bvksound/UPZ_Switcher/BOM/BOM UPZ Switcher.xlsx

Part | Type | Supplier | Amount | Unit price | Total (Unit Price) | Description
N/A |  | JLCPCB | 1 |  | 0 | PCB
NC3FDH (https://benl.rs-online.com/web/p/xlr-connectors/0448250/?searchHistory=%7B%22enabled%22%3Atrue%7D) | XLR | RSComponents | 8 | 4.92 | 39.36
NC3MDH (https://benl.rs-online.com/web/p/xlr-connectors/0448238/?searchHistory=%7B%22enabled%22%3Atrue%7D) | XLR | RSComponents | 2 | 4.77 | 9.54
861-4281 (https://benl.rs-online.com/web/p/leds/8614281/?searchHistory=%7B%22enabled%22%3Atrue%7D) | LED | RSComponents | 4 | 0.128 | 0.512 | LED Green Red
861-4278 (https://benl.rs-online.com/web/p/leds/8614278/?searchHistory=%7B%22enabled%22%3Atrue%7D) | LED | RSComponents | 1 | 0.144 | 0.144 | LED Yellow Red
446-5243 (https://benl.rs-online.com/web/p/d-sub-connectors/4465243/?searchHistory=%7B%22enabled%22%3Atrue%7D) | DB9 | RSComponents | 1 | 2.32 | 2.32 | DB9 connector
TQ2SA-5V (https://benl.rs-online.com/web/p/high-frequency-rf-relays/8154874/) | Relay | RSComponents | 18 | 3.17 | 57.06 | Relay
 | Mosfet |  | 18 |  |  | B170
 | Resistor |  | 4 |  |  | 6K8 Phantom
 | Resistor |  | 18 |  |  | 1K Mosfet
 | Capacitor |  | 18 |  |  | 10nF Mosfet
 | MicroController |  | 1 |  |  | Arduino Micro
 | IO Expander |  | 3 |  |  | MCP23017
 | DIP Socket |  | 3 |  |  | 28 Pin Small
 | DIP Socket |  | 1 |  |  | 29 Pin Wide
 | Capacitor |  | 4 |  |  | 1uF
 | Resistor |  | 2 |  |  | 4K7
 | Resistor |  | 3 |  |  | 10K
 | Diode |  | 18 |  |  | 1N4148
 | DIP Switch |  | 1 |  |  | Address selector
1103961 (https://be.farnell.com/amphenol-icc-fci/71600-310lf/socket-idc-with-s-relief-10way/dp/1103961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) | Header 10 |  | 2
1103937 (https://be.farnell.com/amphenol-icc-fci/71918-110lf/header-straight-10way/dp/1103937?MER=sy-me-pd-mi-acce) | Receptacle 10 |  | 2
1-726386-2 (https://www.mouser.be/ProductDetail/TE-Connectivity-AMP/1-726386-2) | Tags | Mouser | 3
 | Screws
2992519 (https://be.farnell.com/xp-power/ffsas01bfr/iec-filter-ite-6-5mh-1a-qc/dp/2992519?st=main%20filter) | IEC Filter
2671563 (https://be.farnell.com/xp-power/vce05us48/power-supply-ac-dc-48v-0-1a/dp/2671563?st=48v%20dc) | ACDC 48V |  | 1
3583986 (https://be.farnell.com/multicomp-pro/mp-ld05-23b05r2/power-supply-ac-dc-5v-1a/dp/3583986?st=5v%20dc) | ACDC 5V |  | 1
 |  |  |  | Euro | 108.936
