bvksound/UPZ_Switcher/CAD/PSUBoard.dxf

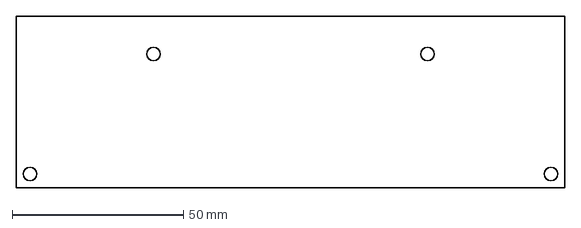
[picture p1: CAD file, 2021-03-16]
CAD/PSUBoard.dxf
160.0 x 50.0 mm
