bvksound/UPZ_Switcher/CAD/RelayBoard.dxf

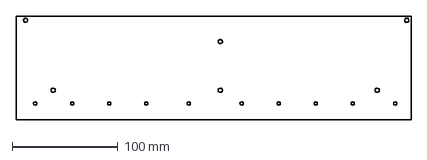
[picture p2: CAD file, 2021-03-13]
CAD/RelayBoard.dxf
373.0 x 98.0 mm
