bvksound/UPZ_Switcher/CAD/MCUBoard.dxf

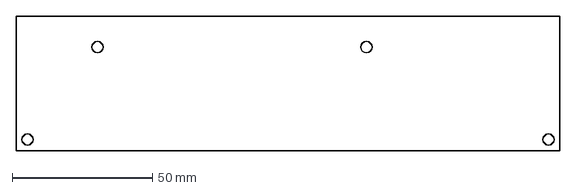
[picture p3: CAD file, 2021-03-13]
CAD/MCUBoard.dxf
194.0 x 48.0 mm
