bvksound/UPZ_Switcher/PCB/UPZ_Switcher/Power Supply.kicad_pcb

## KiCad design PCB/UPZ_Switcher/Power Supply.kicad_pcb (2021-03-26)

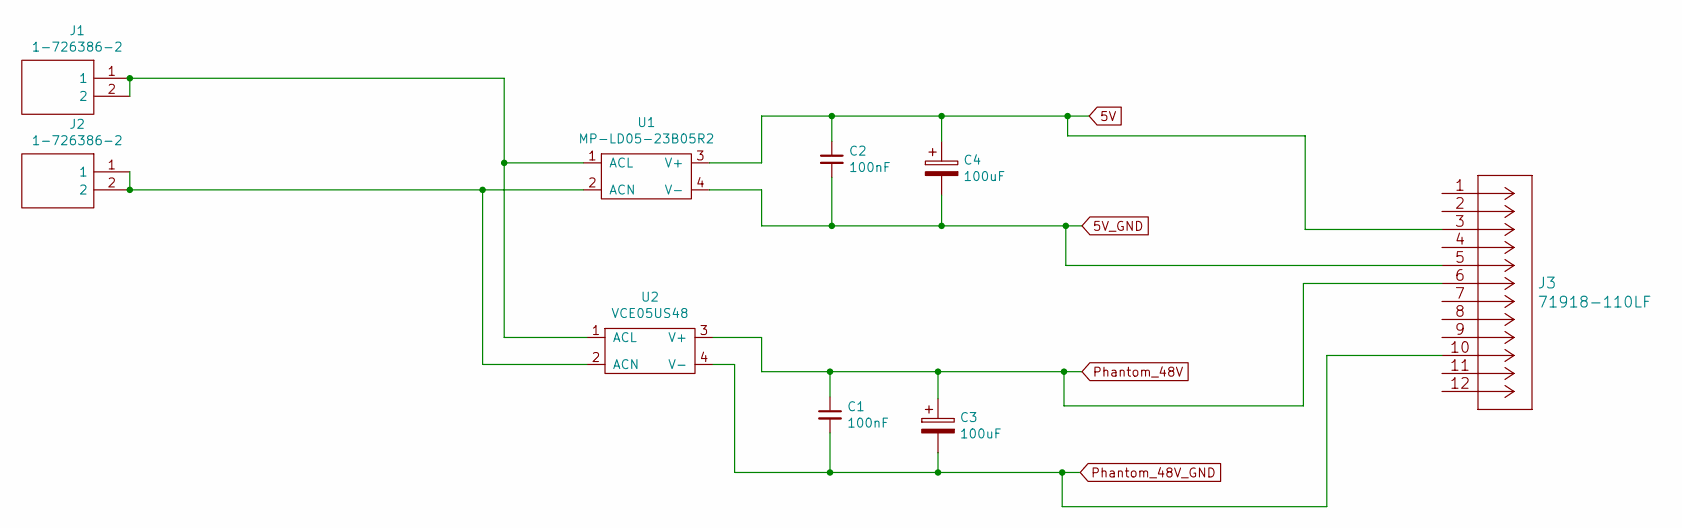
[picture p4: schematic Power Supply.sch]

Parts:
C1, C2: 100nF; C_1206_3216Metric
C3, C4: 100uF; CP_Radial_D10.0mm_P5.00mm
J1, J2: 1-726386-2; 17263862; Manufacturer_Part_Number 1-726386-2; Mouser Part Number 571-1-726386-2
J3: 71918-110LF
U1: MP-LD05-23B05R2
U2: VCE05US48

Connections:
5V: C2.1, C4.1, J3.3, U1.3 (V+)
5V_GND: C2.2, C4.2, J3.5, U1.4 (V-)
unnamed: J1.1, J1.2, U1.1 (ACL), U2.1 (ACL)
unnamed: J2.1, J2.2, U1.2 (ACN), U2.2 (ACN)
Phantom_48V: C1.1, C3.1, J3.6, U2.3 (V+)
Phantom_48V_GND: C1.2, C3.2, J3.10, U2.4 (V-)

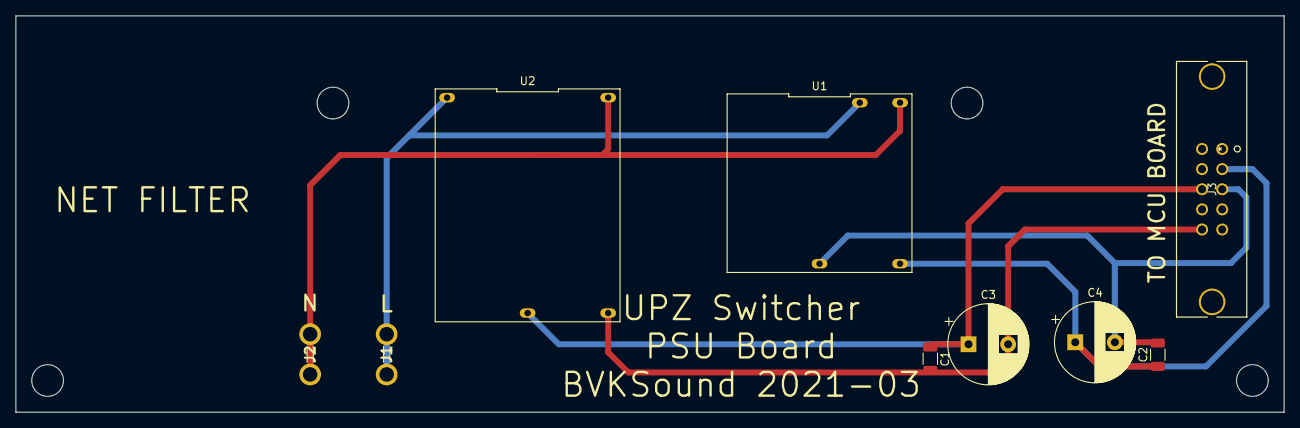
[picture p5: board Power Supply.kicad_pcb from above]

Board: 2 copper layers, 160.0 x 50.0 mm, 9 parts (0 on the bottom side), 6 nets.
