bvksound/UPZ_Switcher/PCB/UPZ_Switcher/Main_Relay_Board.kicad_pcb

## KiCad design PCB/UPZ_Switcher/Main_Relay_Board.kicad_pcb (2021-03-26)

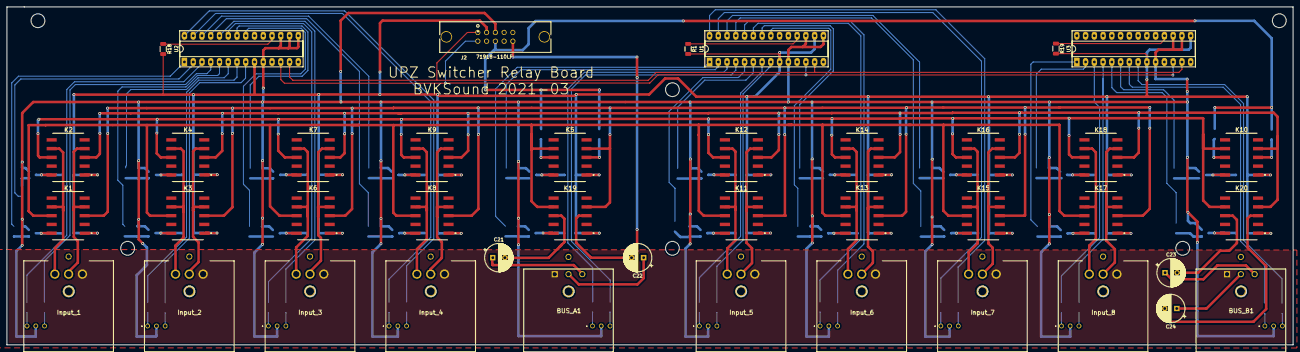
[picture p6: board Main_Relay_Board.kicad_pcb from above]

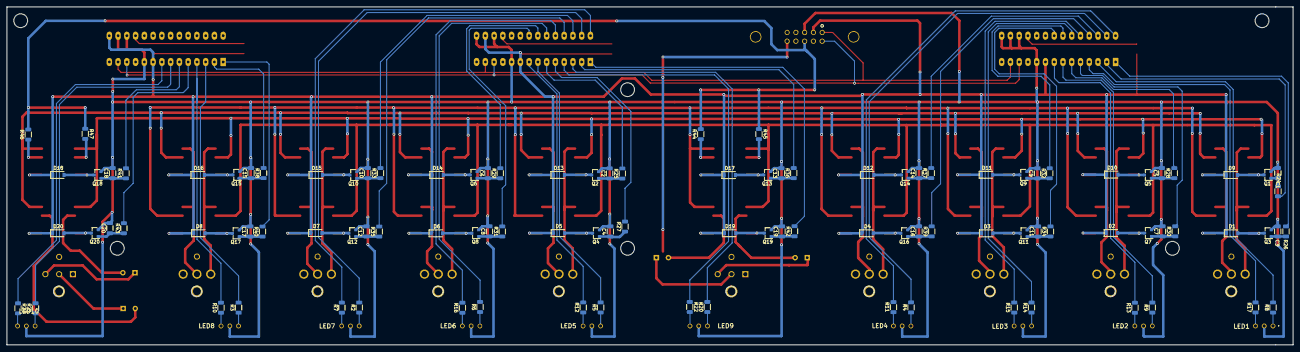
[picture p7: board Main_Relay_Board.kicad_pcb from below]

Board: 2 copper layers, 373.0 x 98.0 mm, 155 parts (105 on the bottom side), 141 nets.

Parts:
BUS_A1: NC3MD-H; NC3MDH
BUS_B1: NC3MD-H; NC3MDH
C1, C2, C3, C4, C5, C6, C7, C8, C9, C10, C11, C12, C13, C14, C15, C16, C17, C18, C19, C20: 10nF; C_1206_3216Metric
C21, C22, C23, C24: 47uF; CP_Radial_D8.0mm_P3.50mm
D1, D2, D3, D4, D5, D6, D7, D8, D9, D10, D11, D12, D13, D14, D15, D16, D17, D18, D19, D20: 1N4148W; D_SOD-123
Input_1, Input_2, Input_3, Input_4, Input_5, Input_6, Input_7, Input_8: NC3FDH
J2: 71918-110LF
K1, K2, K3, K4, K5, K6, K7, K8, K9, K10, K11, K12, K13, K14, K15, K16, K17, K18, K19, K20: TQ2SA-5V-Z; TQ2SAL23VZ
LED1, LED2, LED3, LED4, LED5, LED6, LED7, LED8, LED9, LED10: L-115WEGW; L115WEGW
Q1, Q2, Q3, Q4, Q5, Q6, Q7, Q8, Q9, Q10, Q11, Q12, Q13, Q14, Q15, Q16, Q17, Q18, Q19, Q20: BS170F; SOT-23
R1, R18, R19: 10K; R_1206_3216Metric
R2, R3, R4, R5, R6, R7, R8, R9, R10, R11, R12, R13, R14, R15, R16, R17, R20, R21, R22, R23: 100; R_1206_3216Metric
R24, R25, R26, R27, R28, R29, R30, R31, R32, R33, R34, R35, R36, R37, R38, R39, R40, R41, R42, R43: 1K; R_1206_3216Metric
R44, R45, R46, R47: 6K8; R_1206_3216Metric
U1, U2, U3: MCP23017_SP; DIP-28_W7.62mm_Socket_LongPads

Connections:
/Relay/BUSA.2: K1.8, K3.8, K5.7, K6.8, K8.8, K11.8, K13.8, K15.8, K17.8, K19.7
/Relay/BUSA.3: K1.3, K3.3, K5.4, K6.3, K8.3, K11.3, K13.3, K15.3, K17.3, K19.4
/Relay/BUSB.2: K2.8, K4.8, K7.8, K9.8, K10.7, K12.8, K14.8, K16.8, K18.8, K20.7
/Relay/BUSB.3: K2.3, K4.3, K7.3, K9.3, K10.4, K12.3, K14.3, K16.3, K18.3, K20.4
/Relay/IN1.2: Input_1.2, K1.7, K2.7
/Relay/IN1.3: Input_1.3, K1.4, K2.4
/Relay/IN2.2: Input_2.2, K3.7, K4.7
/Relay/IN2.3: Input_2.3, K3.4, K4.4
/Relay/IN3.2: Input_3.2, K6.7, K7.7
/Relay/IN3.3: Input_3.3, K6.4, K7.4
/Relay/IN4.2: Input_4.2, K8.7, K9.7
/Relay/IN4.3: Input_4.3, K8.4, K9.4
/Relay/IN5.2: Input_5.2, K11.7, K12.7
/Relay/IN5.3: Input_5.3, K11.4, K12.4
/Relay/IN6.2: Input_6.2, K13.7, K14.7
/Relay/IN6.3: Input_6.3, K13.4, K14.4
/Relay/IN7.2: Input_7.2, K15.7, K16.7
/Relay/IN7.3: Input_7.3, K15.4, K16.4
/Relay/IN8.2: Input_8.2, K17.7, K18.7
/Relay/IN8.3: Input_8.3, K17.4, K18.4
/Relay/OUTA.2: BUS_A1.2, C21.1
/Relay/OUTA.3: BUS_A1.3, C22.1
/Relay/OUTB.2: BUS_B1.2, C23.1
/Relay/OUTB.3: BUS_B1.3, C24.1
GND: C1.2, C2.2, C3.2, C4.2, C5.2, C6.2, C7.2, C8.2, C9.2, C10.2, C11.2, C12.2, C13.2, C14.2, C15.2, C16.2, C17.2, C18.2, C19.2, C20.2, J2.5, LED1.2, LED2.2, LED3.2, LED4.2, LED5.2, LED6.2, LED7.2, LED8.2, LED9.2, LED10.2, Q1.2, Q2.2, Q3.2, Q4.2, Q5.2, Q6.2, Q7.2, Q8.2, Q9.2, Q10.2, Q11.2, Q12.2, Q13.2, Q14.2, Q15.2, Q16.2, Q17.2, Q18.2, Q19.2, Q20.2, U1.10, U1.15, U1.17, U2.10, U2.15, U2.16, U2.17, U3.10, U3.16, U3.17
I2C_SCK: J2.2, U1.12, U2.12, U3.12
I2C_SDA: J2.1, U1.13, U2.13, U3.13
K1+: D1.1, D2.1, D3.1, D4.1, D5.1, D6.1, D7.1, D8.1, D9.1, D10.1, D11.1, D12.1, D13.1, D14.1, D15.1, D16.1, D17.1, D18.1, D19.1, D20.1, J2.3, K1.1, K2.1, K3.1, K4.1, K5.1, K6.1, K7.1, K8.1, K9.1, K10.1, K11.1, K12.1, K13.1, K14.1, K15.1, K16.1, K17.1, K18.1, K19.1, K20.1, R1.2, R18.2, R19.2, U1.9, U1.16, U2.9, U3.9, U3.15
K1-: D1.2, K1.10, Q3.3
K2-: D2.2, K3.10, Q7.3
K3-: D3.2, K6.10, Q11.3
K4-: D4.2, K8.10, Q16.3
K5-: D5.2, K11.10, Q4.3
K6-: D6.2, K13.10, Q8.3
K7-: D7.2, K15.10, Q12.3
K8-: D8.2, K17.10, Q17.3
K9-: D9.2, K2.10, Q1.3
K10-: D10.2, K4.10, Q5.3
K11-: D11.2, K7.10, Q9.3
K12-: D12.2, K9.10, Q14.3
K13-: D13.2, K12.10, Q2.3
K14-: D14.2, K14.10, Q6.3
K15-: D15.2, K16.10, Q10.3
K16-: D16.2, K18.10, Q15.3
K17-: D17.2, K5.10, Q13.3
K18-: D18.2, K10.10, Q18.3
K19-: D19.2, K19.10, Q19.3
K20-: D20.2, K20.10, Q20.3
MCP1.1: R26.2, U2.1
MCP1.2: R24.2, U2.2
MCP1.3: R8.2, U2.3
MCP1.4: R17.2, U2.4
MCP1.5: R30.2, U2.5
MCP1.6: R28.2, U2.6
MCP1.7: R9.2, U2.7
MCP1.8: R13.2, U2.8
MCP1.9: R34.2, U2.21
MCP1.10: R32.2, U2.22
MCP1.11: R14.2, U2.23
MCP1.12: R15.2, U2.24
MCP1.13: R39.2, U2.25
MCP1.14: R37.2, U2.26
MCP1.15: R4.2, U2.27
MCP1.16: R11.2, U2.28
MCP2.1: R42.2, U1.1
MCP2.2: R36.2, U1.2
MCP2.3: R20.2, U1.3
MCP2.4: R22.1, U1.4
MCP2.5: R27.2, U1.5
MCP2.6: R25.2, U1.6
MCP2.7: R5.2, U1.7
MCP2.8: R12.2, U1.8
MCP2.9: R31.2, U1.21
MCP2.10: R29.2, U1.22
MCP2.11: R6.2, U1.23
MCP2.12: R16.2, U1.24
MCP2.13: R35.2, U1.25
MCP2.14: R33.2, U1.26
MCP2.15: R2.2, U1.27
MCP2.16: R7.2, U1.28
MCP3.1: R40.2, U3.1
MCP3.2: R38.2, U3.2
MCP3.3: R3.2, U3.3
MCP3.4: R10.2, U3.4
MCP3.5: R43.2, U3.5
MCP3.6: R41.2, U3.6
MCP3.7: R21.2, U3.7
MCP3.8: R23.1, U3.8
unnamed: C1.1, Q1.1, R24.1
unnamed: C2.1, Q2.1, R25.1
unnamed: C3.1, Q3.1, R26.1
unnamed: C4.1, Q4.1, R27.1
unnamed: C5.1, Q5.1, R28.1
unnamed: C6.1, Q6.1, R29.1
unnamed: C7.1, Q7.1, R30.1
unnamed: C8.1, Q8.1, R31.1
unnamed: C9.1, Q9.1, R32.1
unnamed: C10.1, Q10.1, R33.1
unnamed: C11.1, Q11.1, R34.1
unnamed: C12.1, Q12.1, R35.1
unnamed: C13.1, Q13.1, R36.1
unnamed: C14.1, Q14.1, R37.1
unnamed: C15.1, Q15.1, R38.1
unnamed: C16.1, Q16.1, R39.1
unnamed: C17.1, Q17.1, R40.1
unnamed: C18.1, Q18.1, R41.1
unnamed: C19.1, Q19.1, R42.1
unnamed: C20.1, Q20.1, R43.1
unnamed: C21.2, K19.8
unnamed: C22.2, K19.3
unnamed: C23.2, K20.8
unnamed: C24.2, K20.3
unnamed: K5.3, R44.1
unnamed: K5.8, R45.2
unnamed: K10.3, R46.1
unnamed: K10.8, R47.2
unnamed: LED1.1, R8.1
unnamed: LED1.3, R17.1
unnamed: LED2.1, R9.1
unnamed: LED2.3, R13.1
unnamed: LED3.1, R14.1
unnamed: LED3.3, R15.1
unnamed: LED4.1, R4.1
unnamed: LED4.3, R11.1
unnamed: LED5.1, R5.1
unnamed: LED5.3, R12.1
unnamed: LED6.1, R6.1
unnamed: LED6.3, R16.1
unnamed: LED7.1, R2.1
unnamed: LED7.3, R7.1
unnamed: LED8.1, R3.1
unnamed: LED8.3, R10.1
unnamed: LED9.1, R20.1
unnamed: LED9.3, R22.2
unnamed: LED10.1, R21.1
unnamed: LED10.3, R23.2
unnamed: R1.1, U1.18
unnamed: R18.1, U2.18
unnamed: R19.1, U3.18
Phantom_48V: J2.6, R44.2, R45.1, R46.2, R47.1
Phantom_48V_GND: BUS_A1.1, BUS_B1.1, Input_1.1, Input_2.1, Input_3.1, Input_4.1, Input_5.1, Input_6.1, Input_7.1, Input_8.1, J2.10
