bvksound/UPZ_Switcher/PCB/UPZ_Switcher/Microcontroller.kicad_pcb

## KiCad design PCB/UPZ_Switcher/Microcontroller.kicad_pcb (2021-03-26)

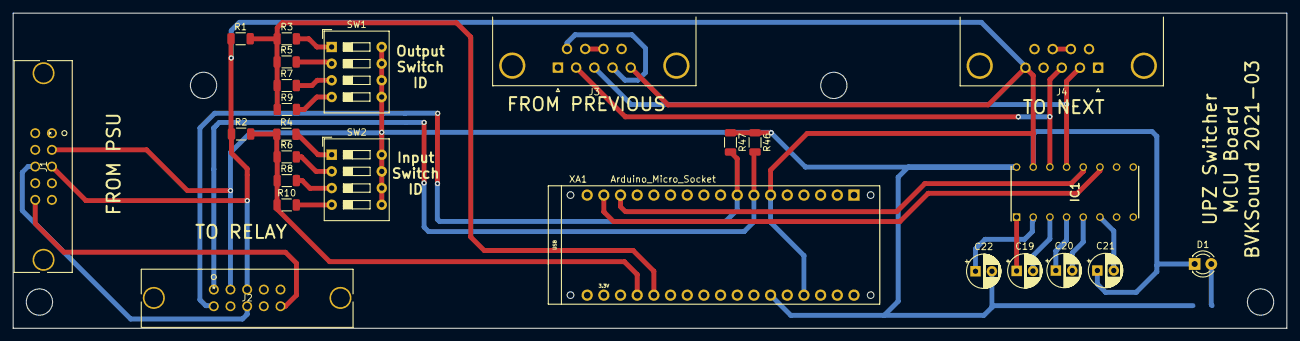
[picture p8: board Microcontroller.kicad_pcb from above]

Board: 2 copper layers, 194.0 x 48.0 mm, 26 parts (1 on the bottom side), 30 nets.

Parts:
C19, C20, C21, C22: 1uF; CP_Radial_D5.0mm_P2.50mm
D1: LED; LED_D3.0mm
IC1: MAX232ECPE+; DIP762W56P254L1918H457Q16N
J1: FROM PSU; 71918-110LF
J2: TO RELAY; 71918-110LF
J3: FROM PREVIOUS; DSUB-9_Female_Horizontal_P2.77x2.84mm_EdgePinOffset4.94mm_H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
J4: TO NEXT; DSUB-9_Male_Horizontal_P2.77x2.84mm_EdgePinOffset4.94mm_Hou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
R1, R2, R3, R4: 10K; R_1206_3216Metric
R5, R6: 20K; R_1206_3216Metric
R7, R8: 40K; R_1206_3216Metric
R9, R10: 80K; R_1206_3216Metric
R11: 100; R_1206_3216Metric
R46, R47: 4K7; R_1206_3216Metric
SW1, SW2: SW_DIP_x04; SW_DIP_SPSTx04_Slide_9.78x12.34mm_W7.62mm_P2.54mm
XA1: Arduino_Micro_Socket

Connections:
/5V: C22.2, IC1.16, J1.3, J2.3, R11.1, R46.1, R47.1, SW1.5, SW1.6, SW1.7, SW1.8, SW2.5, SW2.6, SW2.7, SW2.8, XA1.5V
/I2C_SCK: J2.2, R47.2, XA1.D3
/I2C_SDA: J2.1, R46.2, XA1.D2
GND: C21.1, D1.1, IC1.15, J1.5, J2.5, J3.5, J4.5, R1.1, R2.1, XA1.GND1, XA1.GND2
unnamed: C19.1, IC1.1
unnamed: C19.2, IC1.3
unnamed: C20.1, IC1.4
unnamed: C20.2, IC1.5
unnamed: C21.2, IC1.6
unnamed: C22.1, IC1.2
unnamed: D1.2, R11.2
unnamed: IC1.11, XA1.D11
unnamed: IC1.12, XA1.D10
unnamed: IC1.13, J3.3, J4.2
unnamed: IC1.14, J3.2, J4.3
unnamed: J1.6, J2.6
unnamed: J1.10, J2.10
unnamed: J3.4, J3.6
unnamed: J3.7, J3.8
unnamed: J4.7, J4.8
unnamed: R1.2, R3.1, R5.1, R7.1, R9.1, XA1.A1
unnamed: R3.2, SW1.1
unnamed: R4.2, SW2.1
unnamed: R5.2, SW1.2
unnamed: R6.2, SW2.2
unnamed: R7.2, SW1.3
unnamed: R8.2, SW2.3
unnamed: R9.2, SW1.4
unnamed: R2.2, R4.1, R6.1, R8.1, R10.1, XA1.A0
unnamed: R10.2, SW2.4
