bvksound/UPZ_Switcher/CODE/MCP23017_Blink/MCP23017_Blink.ino

#include <Wire.h>
#include "Adafruit_MCP23017.h"

// Basic pin reading and pullup test for the MCP23017 I/O expander
// public domain!

// Connect pin #12 of the expander to Analog 5 (i2c clock)
// Connect pin #13 of the expander to Analog 4 (i2c data)
// Connect pins #15, 16 and 17 of the expander to ground (address selection)
// Connect pin #9 of the expander to 5V (power)
// Connect pin #10 of the expander to ground (common ground)
// Connect pin #18 through a ~10kohm resistor to 5V (reset pin, active low)

// Input #0 is on pin 21 so connect a button or switch from there to ground

Adafruit_MCP23017 mcp;
  
void setup() {  
  mcp.begin();      // use default address 0

  mcp.pinMode(9, OUTPUT);
  mcp.pinMode(8, OUTPUT);
  //mcp.pullUp(0, HIGH);  // turn on a 100K pullup internally

  //pinMode(13, OUTPUT);  // use the p13 LED as debugging
}



void loop() {
  // The LED will 'echo' the button
  mcp.digitalWrite(9,LOW);
  mcp.digitalWrite(8,LOW);
  delay(2000);
  //mcp.digitalWrite(9,HIGH);
  mcp.digitalWrite(8,HIGH);
  delay(2000);
}
