bvksound/UPZ_Switcher/(commit log)

2021-02-26 Start
    Draft Bom
    [BOM UPZ Switcher.xlsx]
2021-02-28 Draft schematics added
    [BOM UPZ Switcher.xlsx, IO.sch, Microcontroller.sch, PhantomPower.sch, Power Supply.sch, RelayBoard.sch, UPZ_Switcher.kicad_pcb, UPZ_Switcher.sch]
2021-03-06 Updated schematic, PSU added + draft program
    [BOM UPZ Switcher.xlsx, IO.sch, Microcontroller.sch, Power Supply.sch, RelayBoard.sch, UPZ_Switcher.sch]
2021-03-12 Started PCB design
    [IO.sch, MCUBoard.dxf, Main_Relay_Board.kicad_pcb, Main_Relay_Board.sch, Microcontroller.kicad_pcb, Microcontroller.sch, PhantomPower.sch, Power Supply.kicad_pcb]
2021-03-13 Relay Board finished
    [BOM UPZ Switcher.xlsx, IO.sch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]
2021-03-13 updated phantom design + MCU board
    [IO.sch, MCUBoard.dxf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]
2021-03-16 update on power supply
    [BOM UPZ Switcher.xlsx, Main_Relay_Board.kicad_pcb, Microcontroller.kicad_pcb, Microcontroller.sch, PSUBoard.dxf, Power Supply.kicad_pcb, Power Supply.sch]
2021-03-27 fix in gerber files
    [Microcontroller-B_Cu.gbr, Microcontroller-B_Mask.gbr, Microcontroller-B_Paste.gbr, Microcontroller-B_SilkS.gbr, Microcontroller-Edge_Cuts.gbr, Microcontroller-F_Cu.gbr, Microcontroller-F_Mask.gbr, Microcontroller-F_Paste.gbr]
2021-04-11 Update in Phantom Led Blinking
